alianjum-web/low-power-edge-ai-asic-accelerator/docs/figures/supplemental_int4_placement.png

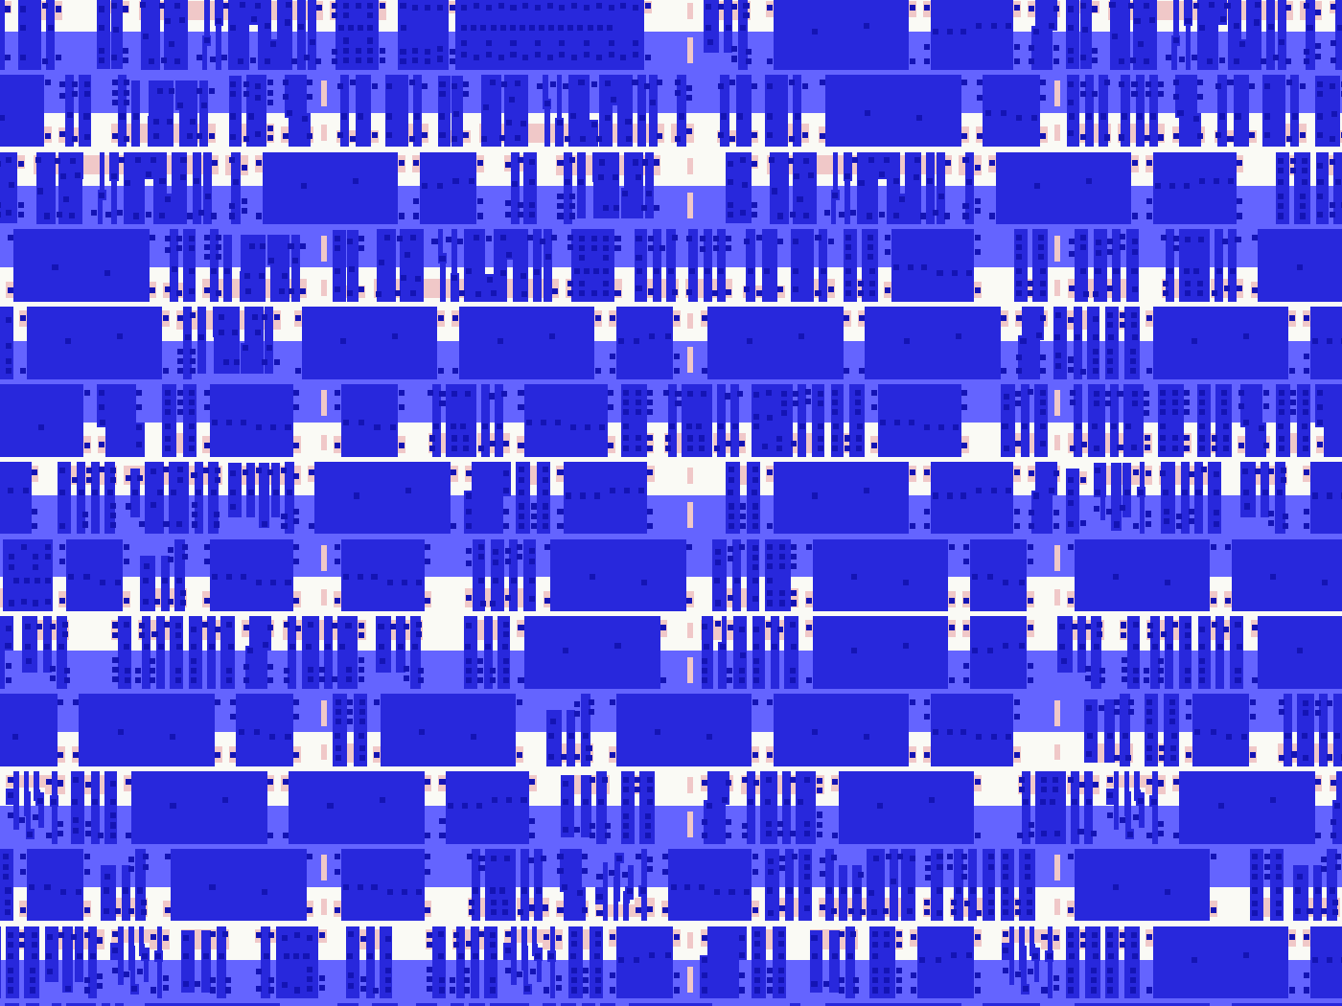
docs/figures/supplemental_int4_placement.png
