alianjum-web/low-power-edge-ai-asic-accelerator/docs/figures/supplemental_int4_routing.png

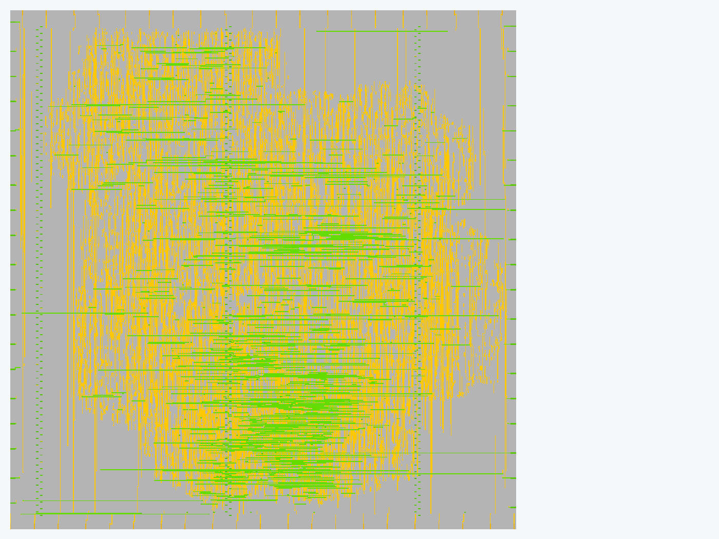
docs/figures/supplemental_int4_routing.png
