alianjum-web/low-power-edge-ai-asic-accelerator/screenshots/int4_parallel/accelerator_top_int4_full_chip.png

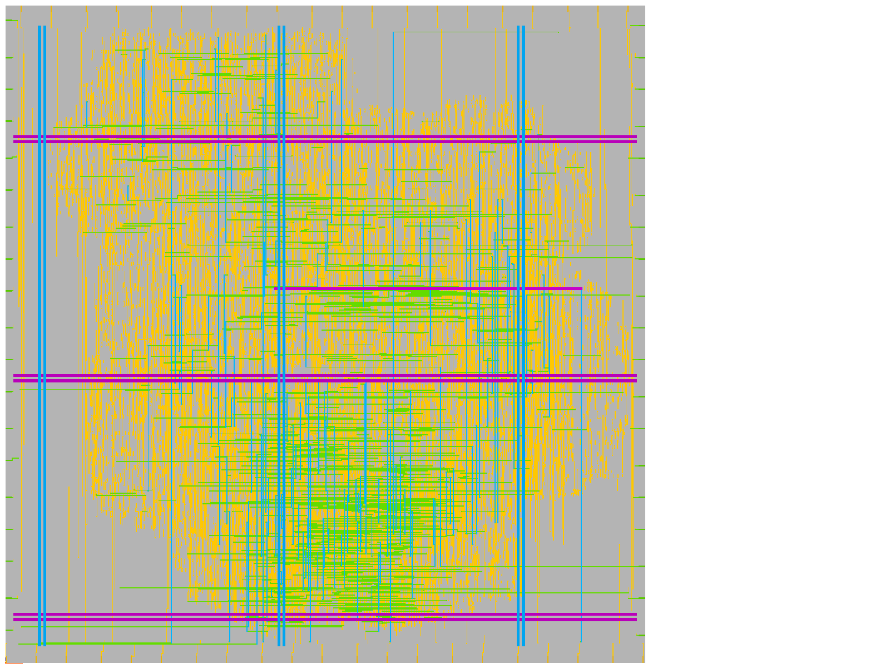
screenshots/int4_parallel/accelerator_top_int4_full_chip.png
