alianjum-web/low-power-edge-ai-asic-accelerator/screenshots/int4_parallel/accelerator_top_int4_placement_detail.png

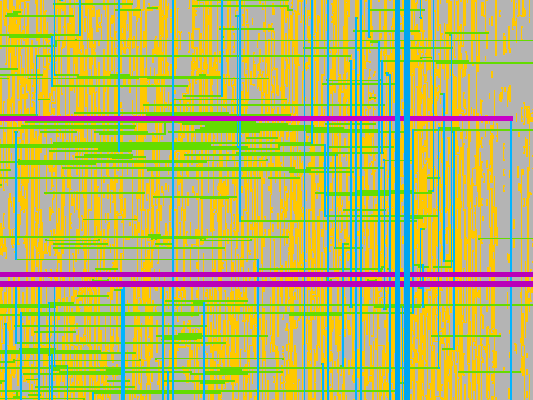
screenshots/int4_parallel/accelerator_top_int4_placement_detail.png
