alianjum-web/low-power-edge-ai-asic-accelerator/screenshots/int8_parallel/accelerator_top_full_chip.png

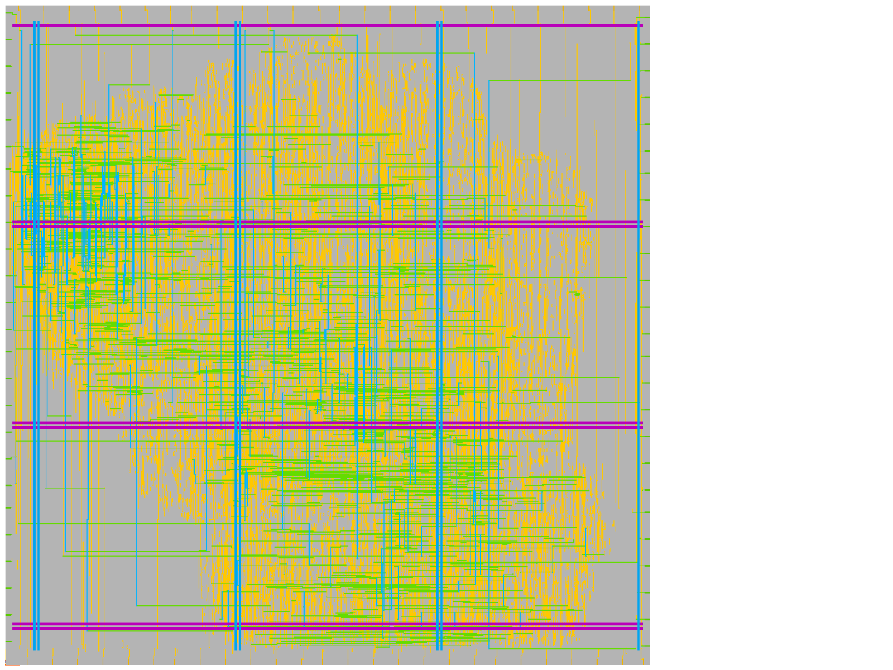
screenshots/int8_parallel/accelerator_top_full_chip.png
