alianjum-web/low-power-edge-ai-asic-accelerator/screenshots/int8_parallel/accelerator_top_placement_detail.png

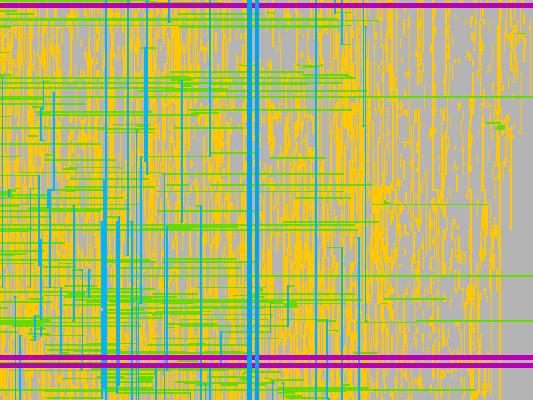
screenshots/int8_parallel/accelerator_top_placement_detail.png
