alianjum-web/low-power-edge-ai-asic-accelerator/screenshots/int8_parallel/accelerator_top_routing_detail.png

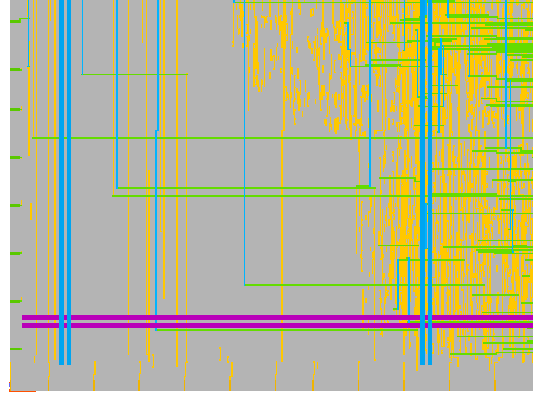
screenshots/int8_parallel/accelerator_top_routing_detail.png
