alianjum-web/low-power-edge-ai-asic-accelerator/results/baseline/metrics.csv

design | design_name | config | flow_status | total_runtime | routed_runtime | (Cell/mm^2)/Core_Util | DIEAREA_mm^2 | CellPer_mm^2 | OpenDP_Util | Final_Util | Peak_Memory_Usage_MB | synth_cell_count | tritonRoute_violations | Short_violations | MetSpc_violations | OffGrid_violations | MinHole_violations | Other_violations | Magic_violations | pin_antenna_violations | net_antenna_violations | lvs_total_errors | cvc_total_errors | klayout_violations | wire_length | vias | wns | pl_wns | optimized_wns | fastroute_wns | spef_wns | tns | pl_tns | optimized_tns | fastroute_tns | spef_tns | HPWL | routing_layer1_pct | routing_layer2_pct | routing_layer3_pct | routing_layer4_pct | routing_layer5_pct | routing_layer6_pct | wires_count | wire_bits | public_wires_count | public_wire_bits | memories_count | memory_bits | processes_count | cells_pre_abc | AND | DFF | NAND | NOR | OR | XOR | XNOR | MUX
/openlane/designs/adder_8bit | adder_8bit | RUN_2026.08.30_06.36.00 | flow completed | 0h0m57s0ms | 0h0m47s0ms | 80169.12815468632 | 0.002577883425 | 24050.738446405892 | 35.38 | -1 | 478.38 | 38 | 0 | 0 | 0 | 0 | 0 | 0 | 0 | 0 | 0 | 0 | -1 | -1 | 1019 | 340 | 0.0 | -1 | -1 | -1 | 0.0 | 0.0 | -1 | -1 | -1 | 0.0 | 931481.0 | 0.0 | 12.53 | 14.37 | 0.0 | 0.0 | 0.0 | 35 | 56 | 3 | 24 | 0 | 0 | 0 | 40 | 1 | 0 | 6 | 5 | 3 | 7 | 8 | 0
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
