alianjum-web/low-power-edge-ai-asic-accelerator/results/int4_parallel/metrics.csv

design | design_name | config | flow_status | total_runtime | routed_runtime | (Cell/mm^2)/Core_Util | DIEAREA_mm^2 | CellPer_mm^2 | OpenDP_Util | Final_Util | Peak_Memory_Usage_MB | synth_cell_count | tritonRoute_violations | Short_violations | MetSpc_violations | OffGrid_violations | MinHole_violations | Other_violations | Magic_violations | pin_antenna_violations | net_antenna_violations | lvs_total_errors | cvc_total_errors | klayout_violations | wire_length | vias | wns | pl_wns | optimized_wns | fastroute_wns | spef_wns | tns | pl_tns | optimized_tns | fastroute_tns | spef_tns | HPWL | routing_layer1_pct | routing_layer2_pct | routing_layer3_pct | routing_layer4_pct | routing_layer5_pct | routing_layer6_pct | wires_count | wire_bits | public_wires_count | public_wire_bits | memories_count | memory_bits | processes_count | cells_pre_abc | AND | DFF | NAND | NOR | OR | XOR | XNOR | MUX
/project/designs/accelerator_int4_parallel | accelerator_top_int4 | project_run_01 | flow completed | 0h10m56s0ms | 0h8m49s0ms | 100705.26714237944 | 0.172923286025 | 35246.8434998328 | 36.11 | -1 | 846.71 | 5553 | 0 | 0 | 0 | 0 | 0 | 0 | 0 | 14 | 11 | 0 | -1 | -1 | 218620 | 43613 | 0.0 | -1 | -1 | -1 | 0.0 | 0.0 | -1 | -1 | -1 | 0.0 | 162992063.0 | 0.0 | 36.14 | 37.93 | 8.07 | 10.36 | 0.0 | 5858 | 7189 | 155 | 1485 | 0 | 0 | 0 | 6147 | 88 | 0 | 118 | 348 | 839 | 728 | 415 | 915
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
