alianjum-web/low-power-edge-ai-asic-accelerator/testbench/README.md

# Adder testbench (original path)

Canonical copy for the new layout: `../verification/tb_adder_8bit.v`.
Local `adder_sim` and `*.vcd` are gitignored.
