alianjum-web/low-power-edge-ai-asic-accelerator/verification/reference/README.md

# Golden vectors

Place Python-generated INT8 inputs, weights, biases, and expected outputs here (`.hex` / `.csv`). Empty until Phase 1.
