alianjum-web/low-power-edge-ai-asic-accelerator/verification/reference/vectors_int4.csv

x0 | x1 | x2 | x3 | x4 | x5 | x6 | x7 | w00 | w01 | w02 | w03 | w10 | w11 | w12 | w13 | w20 | w21 | w22 | w23 | w30 | w31 | w32 | w33 | w40 | w41 | w42 | w43 | w50 | w51 | w52 | w53 | w60 | w61 | w62 | w63 | w70 | w71 | w72 | w73 | b0 | b1 | b2 | b3 | acc0 | acc1 | acc2 | acc3 | y0 | y1 | y2 | y3
7 | 7 | 7 | -2 | -6 | 6 | -7 | -4 | -6 | -3 | 0 | -7 | 4 | -5 | 4 | -3 | 4 | 7 | 7 | -4 | 0 | -1 | -4 | 1 | 6 | 5 | 2 | 5 | 0 | 2 | 7 | 2 | -8 | 3 | 3 | -5 | 5 | -6 | 4 | 5 | -1 | -4 | -3 | 1 | 13 | -24 | 75 | -102 | 1 | 0 | 5 | 0
-8 | 2 | -6 | 1 | 0 | -8 | -6 | 7 | -2 | -1 | -1 | 0 | -5 | -8 | 2 | -4 | 2 | 5 | -2 | -2 | -6 | 3 | 3 | 6 | 4 | -6 | 4 | 7 | -3 | -6 | 5 | 7 | 7 | -7 | 6 | -1 | -2 | 5 | 6 | -4 | 2 | 2 | 2 | 3 | -42 | 92 | -5 | -65 | 0 | 6 | 0 | 0
-3 | 5 | -2 | -1 | 4 | -3 | 4 | -1 | -8 | -7 | 4 | -5 | 7 | 0 | -6 | 3 | -5 | -1 | 1 | -4 | 2 | 7 | -3 | 4 | -4 | -1 | -7 | -1 | 2 | 3 | -3 | 5 | 0 | -4 | -5 | 3 | 0 | 4 | 4 | 6 | -3 | -4 | -1 | 0 | 42 | -21 | -85 | 21 | 3 | 0 | 0 | 1
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
