alianjum-web/low-power-edge-ai-asic-accelerator/verification/reference/vectors.csv

x0 | x1 | x2 | x3 | x4 | x5 | x6 | x7 | w00 | w01 | w02 | w03 | w10 | w11 | w12 | w13 | w20 | w21 | w22 | w23 | w30 | w31 | w32 | w33 | w40 | w41 | w42 | w43 | w50 | w51 | w52 | w53 | w60 | w61 | w62 | w63 | w70 | w71 | w72 | w73 | b0 | b1 | b2 | b3 | acc0 | acc1 | acc2 | acc3 | y0 | y1 | y2 | y3
122 | 122 | 124 | -31 | -85 | 108 | -102 | -62 | -93 | -47 | 9 | -98 | 75 | -67 | 73 | -47 | 75 | 118 | 117 | -61 | 14 | -16 | -63 | 28 | 101 | 93 | 37 | 93 | 4 | 44 | 116 | 40 | -116 | 60 | 61 | -71 | 93 | -84 | 73 | 94 | -35 | -880 | -676 | 367 | 4548 | -3725 | 24424 | -27926 | 18 | 0 | 95 | 0
-118 | 43 | -93 | 28 | 12 | -113 | -83 | 122 | -25 | -16 | -12 | 8 | -79 | -128 | 37 | -64 | 40 | 91 | -18 | -20 | -83 | 60 | 50 | 108 | 70 | -89 | 77 | 126 | -37 | -82 | 90 | 112 | 121 | -106 | 97 | -9 | -18 | 84 | 103 | -57 | 520 | 738 | 730 | 952 | -13189 | 17583 | 2080 | -15211 | 0 | 69 | 8 | 0
-44 | 87 | -20 | -14 | 65 | -34 | 64 | -5 | -126 | -105 | 67 | -70 | 124 | 9 | -85 | 59 | -78 | -14 | 20 | -50 | 45 | 114 | -38 | 64 | -57 | -8 | -100 | -11 | 43 | 63 | -48 | 90 | 5 | -53 | -65 | 59 | 1 | 79 | 70 | 99 | -507 | -951 | -163 | 25 | 11903 | -3313 | -19752 | 7848 | 46 | 0 | 0 | 31
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
