alianjum-web/low-power-edge-ai-asic-accelerator/(commit log)

2026-09-01 Initial commit: Add project structure including .gitignore, LICENSE, and documentation for design and algorithm phases. Implement 8-bit adder RTL and testbench, along with OpenLane configuration for 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
    [comparison.csv, metrics.csv]
2026-09-06 Update .gitignore to include additional Python, simulation, and report artifacts; add top-level Makefile for RTL-to-GDS flow orchestration
2026-09-06 Add AGENTS.md for project guidelines, update README.md and research_question.md, create Makefiles for flow and verification, and remove obsolete RTL and testbench files
2026-09-08 Complete Sprint 4: measured INT8 4-way baseline through OpenLane GDSII
    Runs the verified accelerator_top RTL through OpenLane (project_run_02,
    v1.0.2) to a completed GDS with clean DRC/LVS/XOR/routing/setup/hold and
    documented antenna/max-fanout follow-ups. Curates the run into
    results/int8_parallel/ (metrics.csv, signoff.md, final GDS) and updates
    docs/physical_design.md, docs/01_status_and_roadmap.md, and README.md to
    reflect the measured baseline instead of a pending one.
    Also folds in the supporting Version 1 work this baseline depends on:
    the quantization-aware Python reference model and frozen test vectors,
    the four-PE accelerator RTL/testbenches, the inherited SiliconNPU
    baseline mat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
    [baseline_results.csv, comparison.csv, metrics.csv, vectors.csv]
2026-09-08 Add INT4/INT8 quantization pipeline and expand Python baseline (Sprint 1)
    Adds quantization support, test-vector generation, and accuracy
    measurement on top of the existing floating-point reference model, and
    folds python/README.md into algorithm/README.md as the single source
    of truth for the algorithm baseline.
    [baseline_results.csv]
2026-09-08 Add testbenches and reference-vector verification for SiliconNPU RTL (Sprint 3)
    Adds directed testbenches for the MAC core, processing element, and
    top-level accelerator/NPU RTL, checked against golden reference
    vectors generated from the Python quantized model. Extends run_sim.sh
    to drive the new testbenches and adds a script to cross-check RTL
    output against the reference vectors.
    [vectors.csv, vectors_int4.csv]
2026-09-08 Add openmac flow-orchestration tool for OpenLane synthesis/PD (Sprint 4)
    Introduces the openmac package (SDC/OpenROAD-flow Tcl generation,
    staged run logging, report analysis) to drive the RTL-to-GDSII flow
    from Python instead of hand-written Tcl, plus per-design OpenLane
    configs and helper scripts for constraint generation, report parsing,
    and a results dashboard.
2026-09-08 Add GDSII sign-off results and PPA comparison across designs (Sprints 5-7)
    Adds OpenLane sign-off GDS/metrics for the MAC core, pipelined MAC
    core, SiliconNPU top level, and the INT4/INT8 parallel accelerator
    variants, along with layout screenshots and the scripts used to render
    them. Records the cross-design PPA comparison and low-power
    optimization results, and removes the stale physical_design/README.md
    now superseded by docs/physical_design.md.
    [comparison.csv, metrics.csv]
2026-09-08 Update project status, roadmap, and contributor docs
    Refreshes README.md, AGENTS.md, the status/roadmap and eight-week
    sprint plan docs, research methodology notes, and the scripts README
    to reflect the completed algorithm, RTL, verification, flow-tooling,
    and physical-design work landing across the other Sprint 1-7 PRs.
2026-09-09 Complete Sprint 8: research package (figures, report, PPA docs)
    Add the 10 required + 3 supplemental figures (architecture diagrams,
    RTL waveform, GDS stage-layer renders, PPA/accuracy/trade-off charts)
    generated by new checked-in scripts (render_gds_stage_views.py,
    plot_rtl_waveform.py, plot_ppa_charts.py) driven off real repo
    artifacts and results/comparison.csv, plus the 17-section technical
    report in docs/report/report.md.
    Update README, AGENTS.md, docs/01_status_and_roadmap.md,
    results/README.md, and results/comparison.csv with real measured
    INT8/INT4 PPA numbers and explicit notes on the Sprint 6 scope cut
    for the sequential-schedule variants, replacing stale TBD/Phase-0
    status text.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
    [comparison.csv]
